reneayoroa/Instrumented-Insole/README.md

# Instrumented-Insole
KiCAD Design files for an instrumented insole
