reneayoroa/Instrumented-Insole/Design_Files/Smart_Insole_2025/Smart_insoles_2025_v1/Project_library/20pin_1.00mm_connector_horizontal/ZF1-20-02-TM-WT.stp

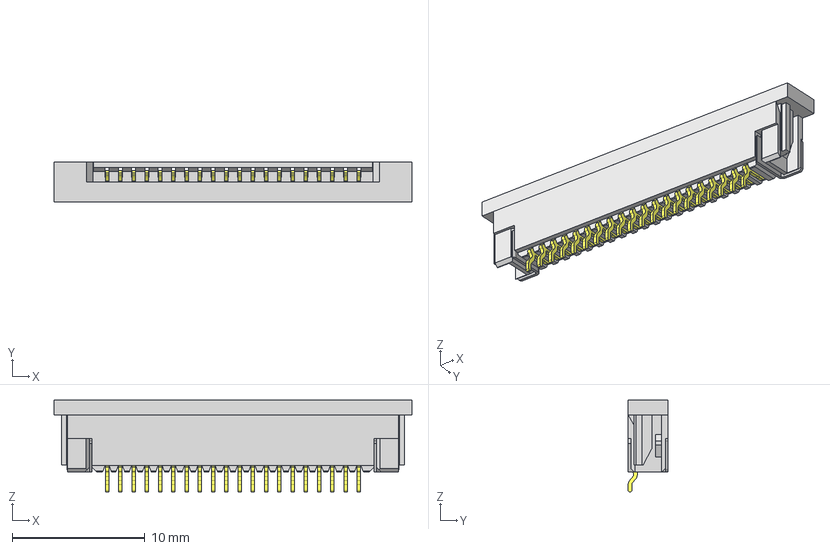
[picture p1: CAD file, 2025-10-01]
Design_Files/Smart_Insole_2025/Smart_insoles_2025_v1/Project_library/20pin_1.00mm_connector_horizontal/ZF1-20-02-TM-WT.stp
27.0 x 3.01 x 6.91 mm
ZF1-20-02-WT_housing
ZF1-20-02-WT_wt
ZF1-20-02-WT_contact
ZF1-02_CS2
ZF1-02_cs
