reneayoroa/Instrumented-Insole/Design_Files/Smart_Insole_2025/Smart_insoles_2025_v1/Project_library/3x3_TrimPot/TC33X-2-302E.step

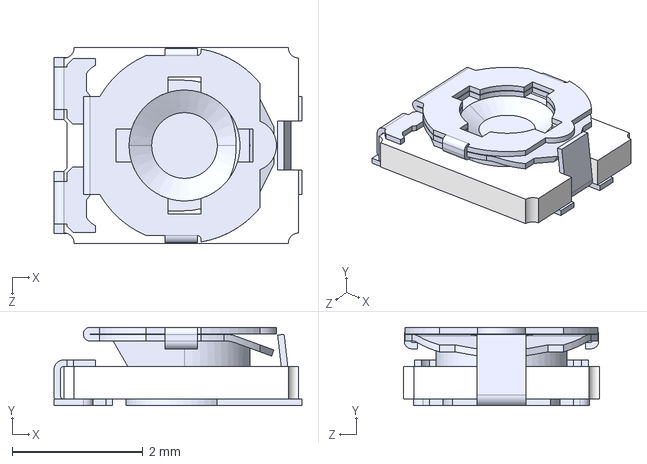
[picture p2: CAD file, 2025-08-20]
Design_Files/Smart_Insole_2025/Smart_insoles_2025_v1/Project_library/3x3_TrimPot/TC33X-2-302E.step
3.80 x 1.20 x 3.00 mm
