reneayoroa/Instrumented-Insole/Design_Files/Smart_Insole_2025/Smart_insoles_2025_v1/Project_library/ADM8829/ADM8829ARTZ-REEL.step

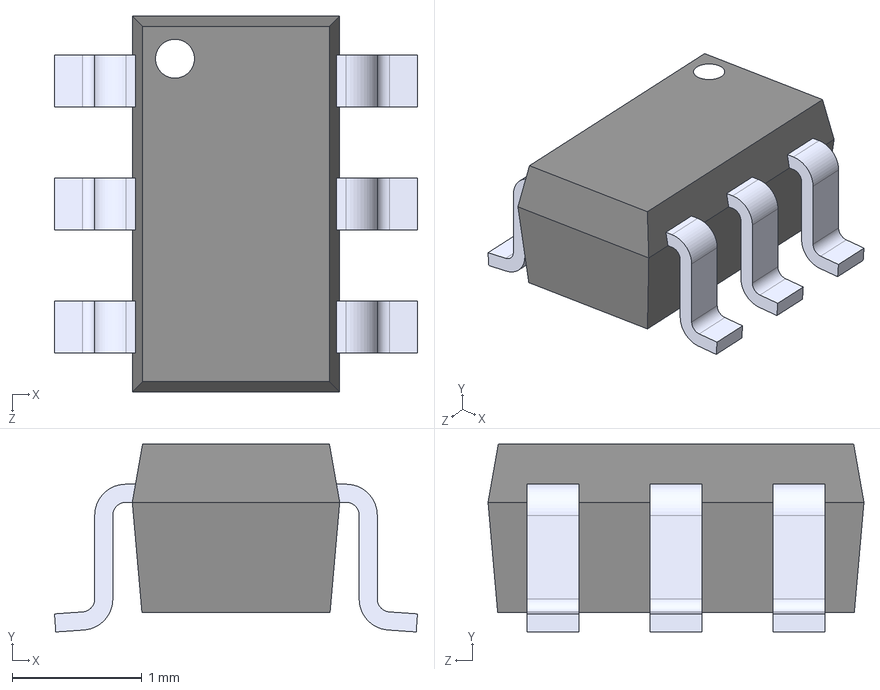
[picture p3: CAD file, 2025-07-16]
Design_Files/Smart_Insole_2025/Smart_insoles_2025_v1/Project_library/ADM8829/ADM8829ARTZ-REEL.step
2.80 x 1.45 x 2.90 mm
