reneayoroa/Instrumented-Insole/Design_Files/Smart_Insole_2025/Smart_insoles_2025_v1/Project_library/CD74HC4067M96--3DModel-STEP-56544.STEP

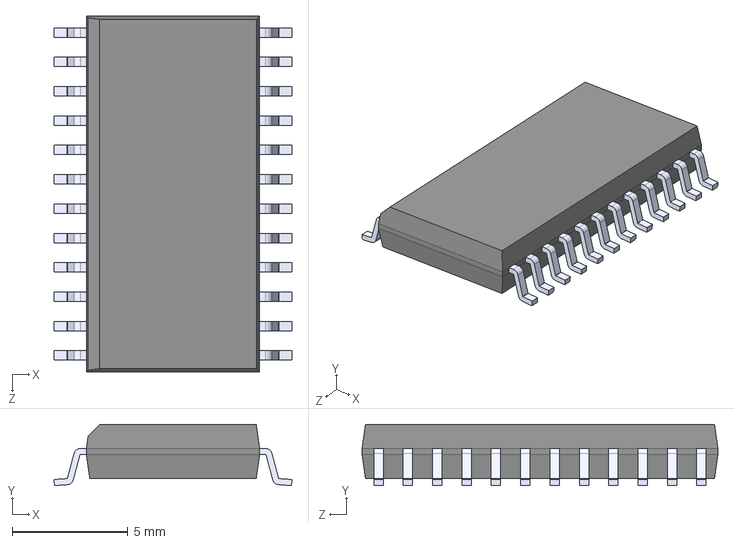
[picture p4: CAD file, 2025-06-03]
Design_Files/Smart_Insole_2025/Smart_insoles_2025_v1/Project_library/CD74HC4067M96--3DModel-STEP-56544.STEP
10.3 x 2.65 x 15.4 mm
