reneayoroa/Instrumented-Insole/Design_Files/Smart_Insole_2025/Smart_insoles_2025_v1/Project_library/ESP32-C3-MINI-1-N4/ESP32-C3-MINI-1-N4.step

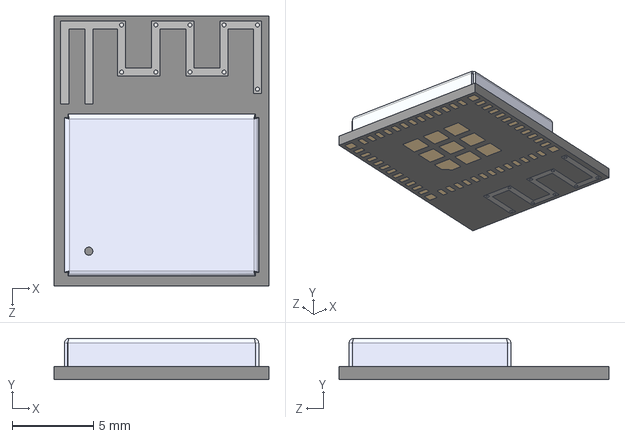
[picture p5: CAD file, 2025-09-10]
Design_Files/Smart_Insole_2025/Smart_insoles_2025_v1/Project_library/ESP32-C3-MINI-1-N4/ESP32-C3-MINI-1-N4.step
13.2 x 2.55 x 16.6 mm
