reneayoroa/Instrumented-Insole/Design_Files/Smart_Insole_2025/Smart_insoles_2025_v1/Project_library/ESP32-C3_SUPERMINI_SMD/ESP32-C3_SUPERMINI_SMD.step

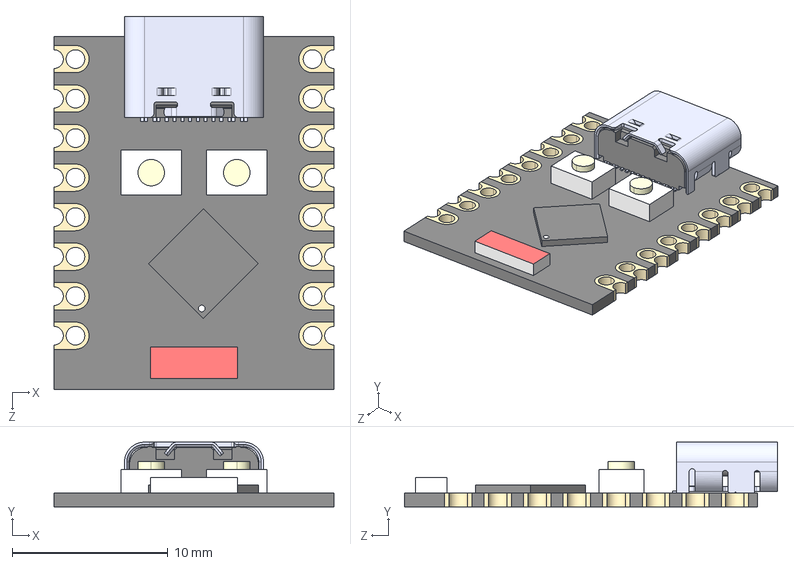
[picture p6: CAD file, 2025-06-03]
Design_Files/Smart_Insole_2025/Smart_insoles_2025_v1/Project_library/ESP32-C3_SUPERMINI_SMD/ESP32-C3_SUPERMINI_SMD.step
18.0 x 4.16 x 24.0 mm
Board c3mini
USB C
components (other)^ESP32-C3 SuperMini
