reneayoroa/Instrumented-Insole/Design_Files/Smart_Insole_2025/Smart_insoles_2025_v1/Project_library/FDN306P/FDN306P.step

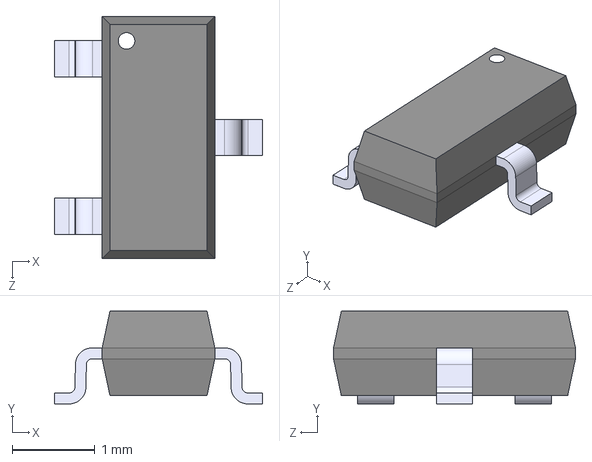
[picture p7: CAD file, 2025-09-24]
Design_Files/Smart_Insole_2025/Smart_insoles_2025_v1/Project_library/FDN306P/FDN306P.step
2.51 x 1.12 x 2.92 mm
