reneayoroa/Instrumented-Insole/Design_Files/Smart_Insole_2025/Smart_insoles_2025_v1/Project_library/GY-521/GY-521.step

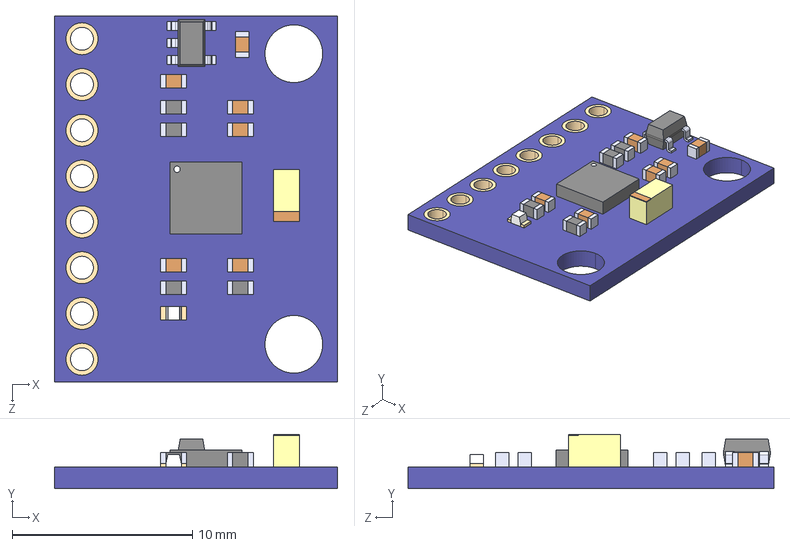
[picture p8: CAD file, 2025-06-03]
Design_Files/Smart_Insole_2025/Smart_insoles_2025_v1/Project_library/GY-521/GY-521.step
15.7 x 3.00 x 20.3 mm
