reneayoroa/Instrumented-Insole/Design_Files/Smart_Insole_2025/Smart_insoles_2025_v1/Project_library/JST-PH2-2.00MM-SMD-HORIZONTAL/S2B-PH-SM4-TB_LF__SN_.step

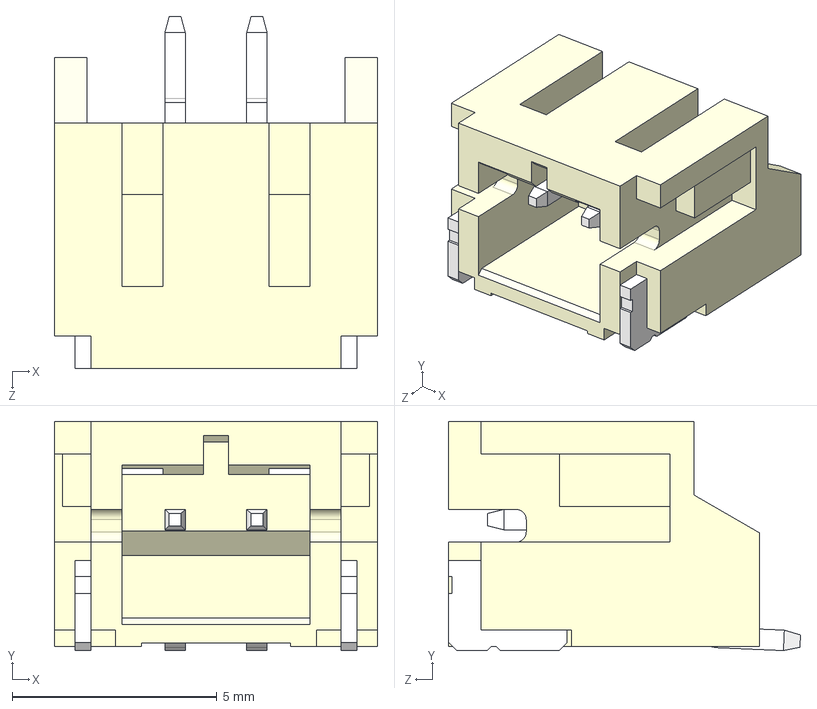
[picture p9: CAD file, 2025-08-27]
Design_Files/Smart_Insole_2025/Smart_insoles_2025_v1/Project_library/JST-PH2-2.00MM-SMD-HORIZONTAL/S2B-PH-SM4-TB_LF__SN_.step
7.90 x 5.60 x 8.60 mm
