reneayoroa/Instrumented-Insole/Design_Files/Smart_Insole_2025/Smart_insoles_2025_v1/Project_library/LDM6S032TR/LSM6DSO32TR.step

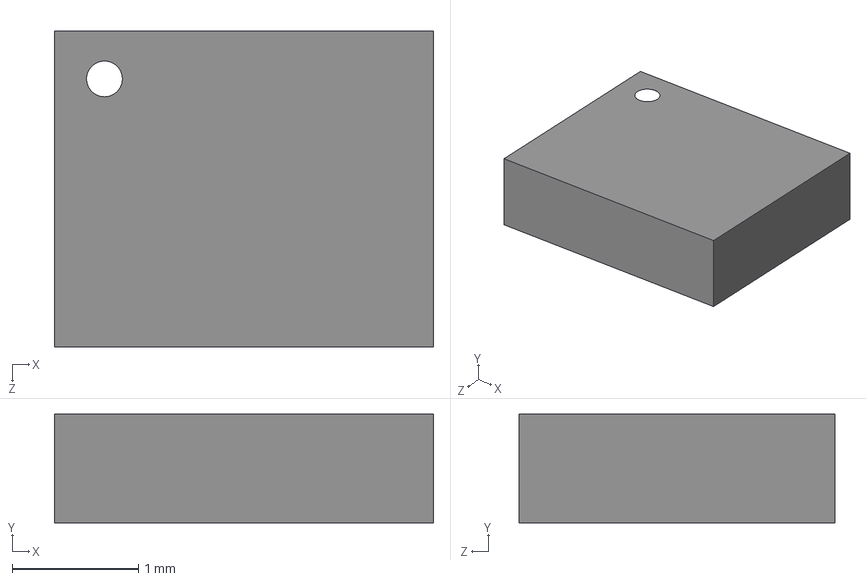
[picture p10: CAD file, 2025-08-26]
Design_Files/Smart_Insole_2025/Smart_insoles_2025_v1/Project_library/LDM6S032TR/LSM6DSO32TR.step
3.00 x 0.86 x 2.50 mm
