reneayoroa/Instrumented-Insole/Design_Files/Smart_Insole_2025/Smart_insoles_2025_v1/Project_library/MCP6004_I_ST/MCP6004-I_ST.step

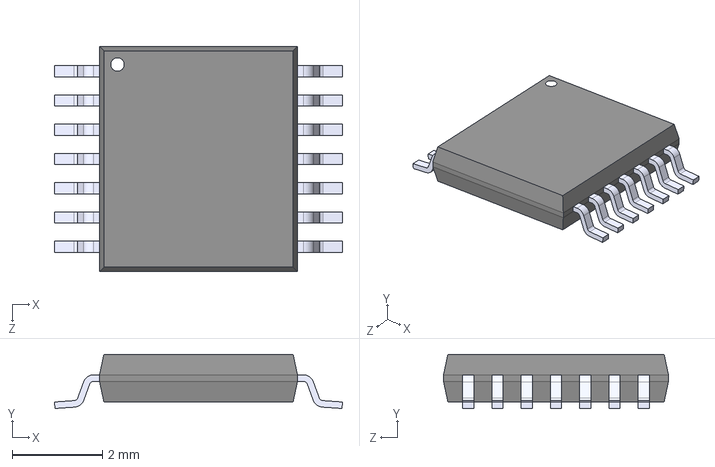
[picture p11: CAD file, 2025-08-19]
Design_Files/Smart_Insole_2025/Smart_insoles_2025_v1/Project_library/MCP6004_I_ST/MCP6004-I_ST.step
6.40 x 1.20 x 5.00 mm
