reneayoroa/Instrumented-Insole/Design_Files/Smart_Insole_2025/Smart_insoles_2025_v1/Project_library/USBLC6-2SC6/USBLC6-2SC6.stp

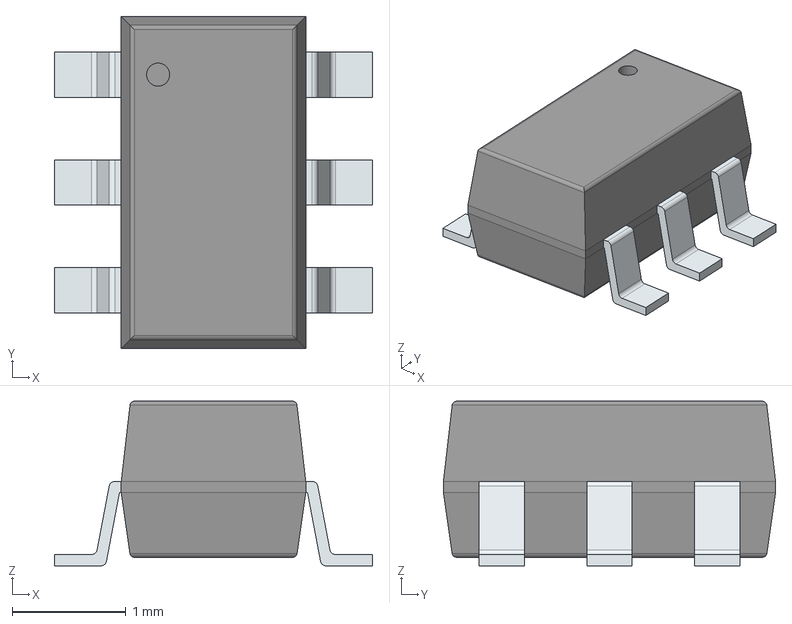
[picture p12: CAD file, 2025-10-01]
Design_Files/Smart_Insole_2025/Smart_insoles_2025_v1/Project_library/USBLC6-2SC6/USBLC6-2SC6.stp
2.80 x 2.92 x 1.45 mm
PinsArrayLR
