reneayoroa/Instrumented-Insole/Design_Files/Smart_Insole_2025/Smart_insoles_2025_v1/Project_library/BQ24040DSQR/BQ24040DSQR.step

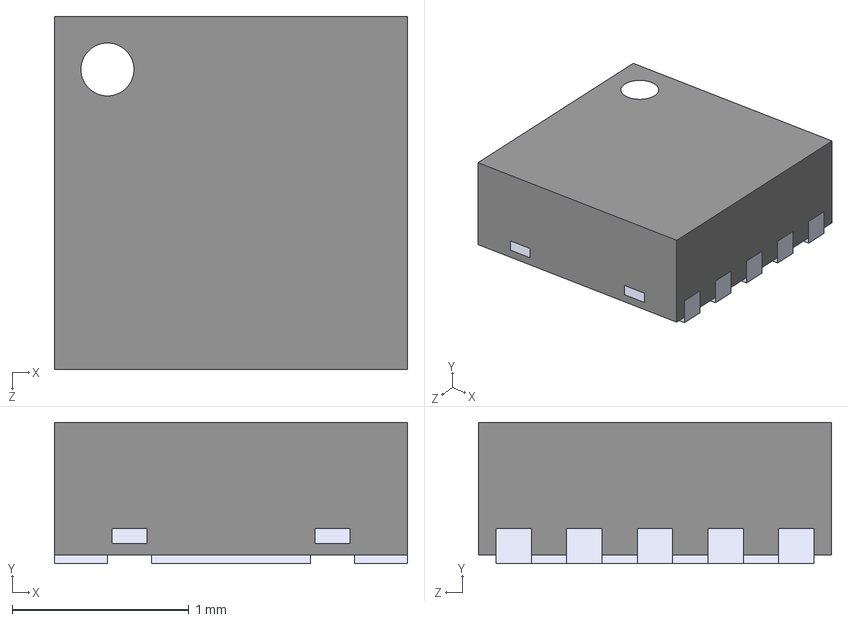
[picture p13: CAD file, 2025-09-25]
Design_Files/Smart_Insole_2025/Smart_insoles_2025_v1/Project_library/BQ24040DSQR/BQ24040DSQR.step
2.00 x 0.8 x 2.00 mm
