reneayoroa/Instrumented-Insole/Design_Files/Smart_Insole_2025/Smart_insoles_2025_v1/Output_files/Smart_insoles_2025_v1.pdf

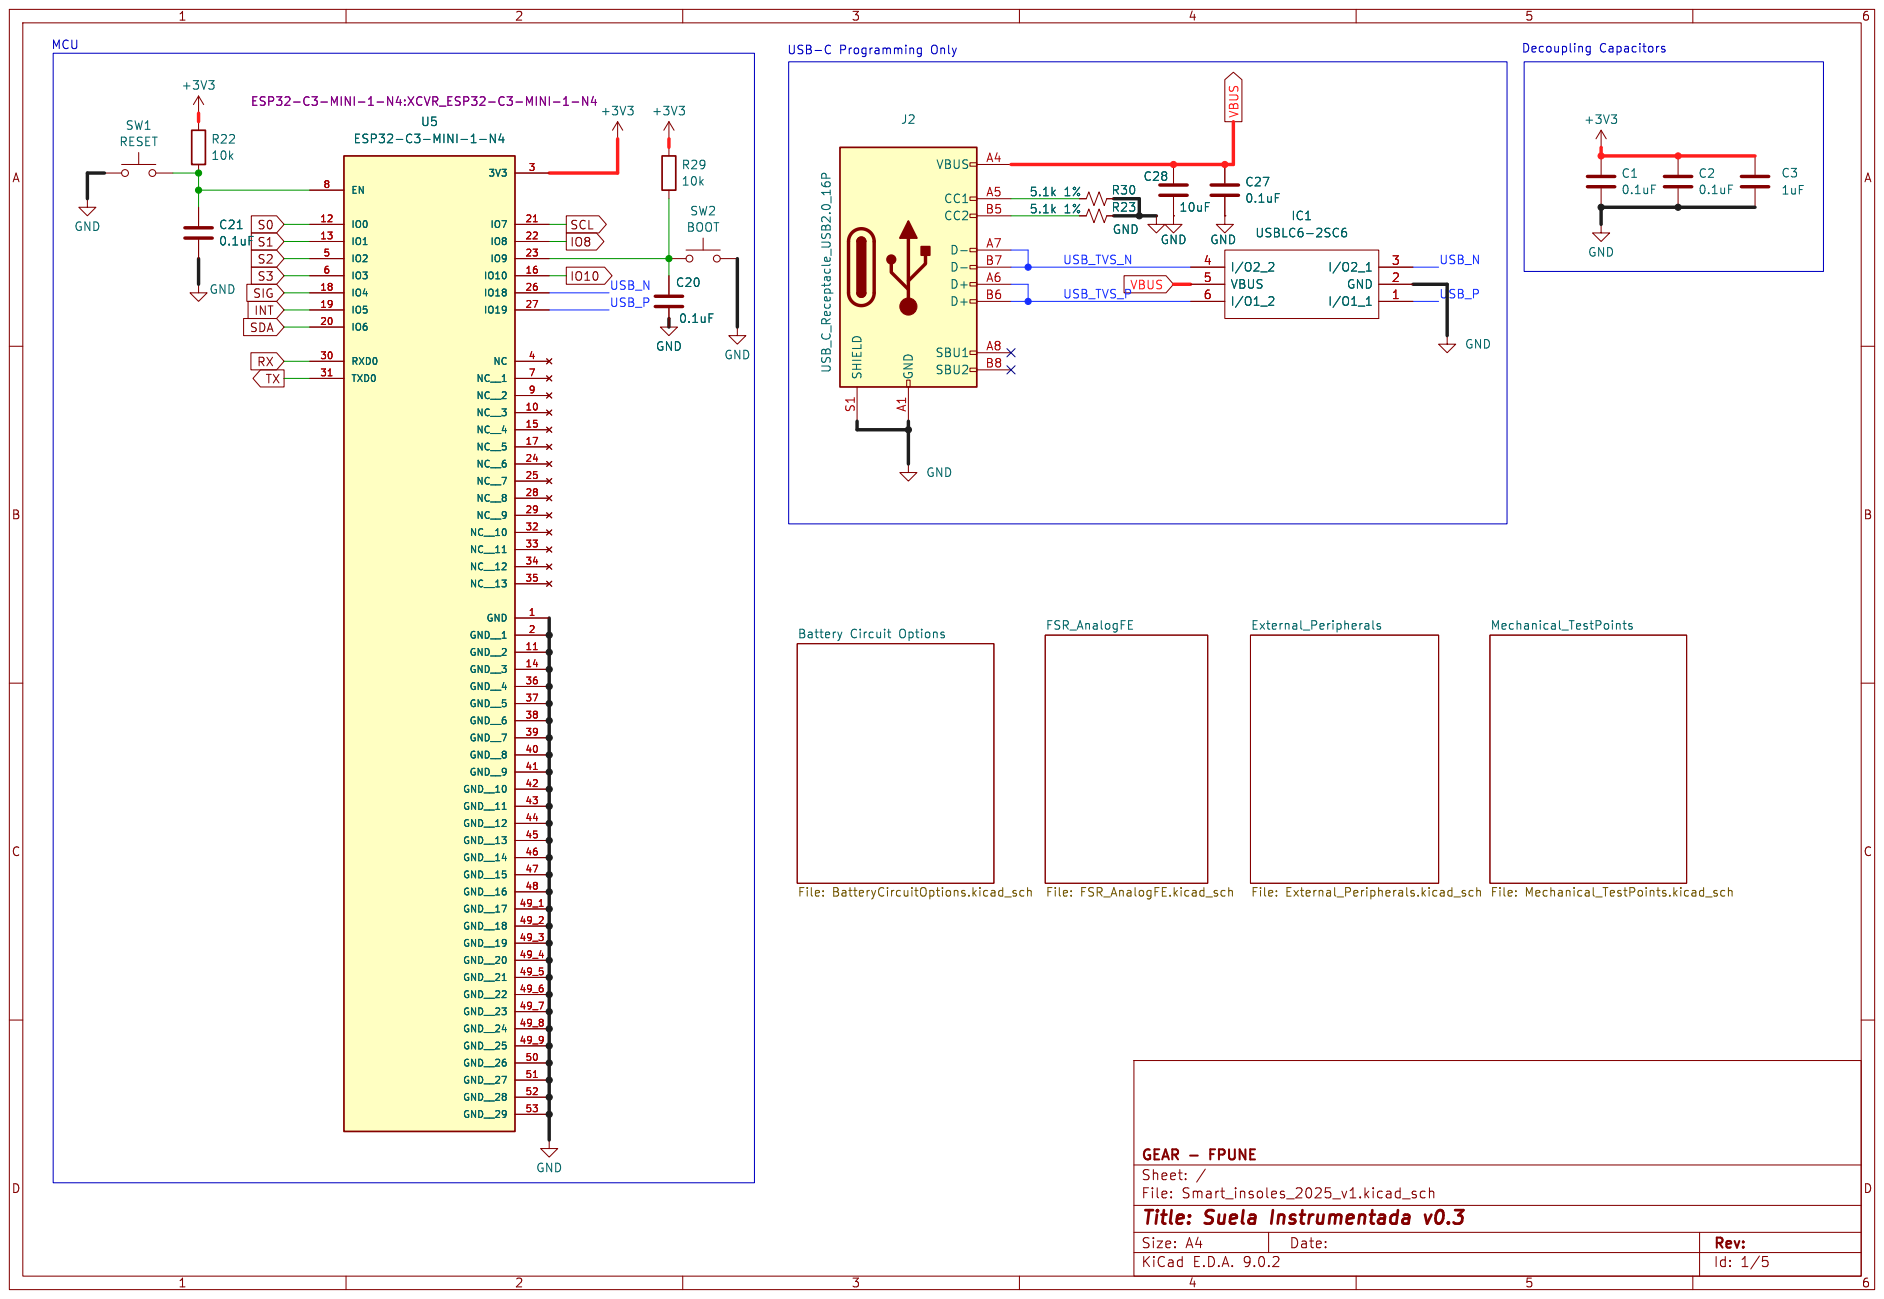
[picture p14: page 1]

Battery Circuit Options File: BatteryCircuitOptions.kicad_sch

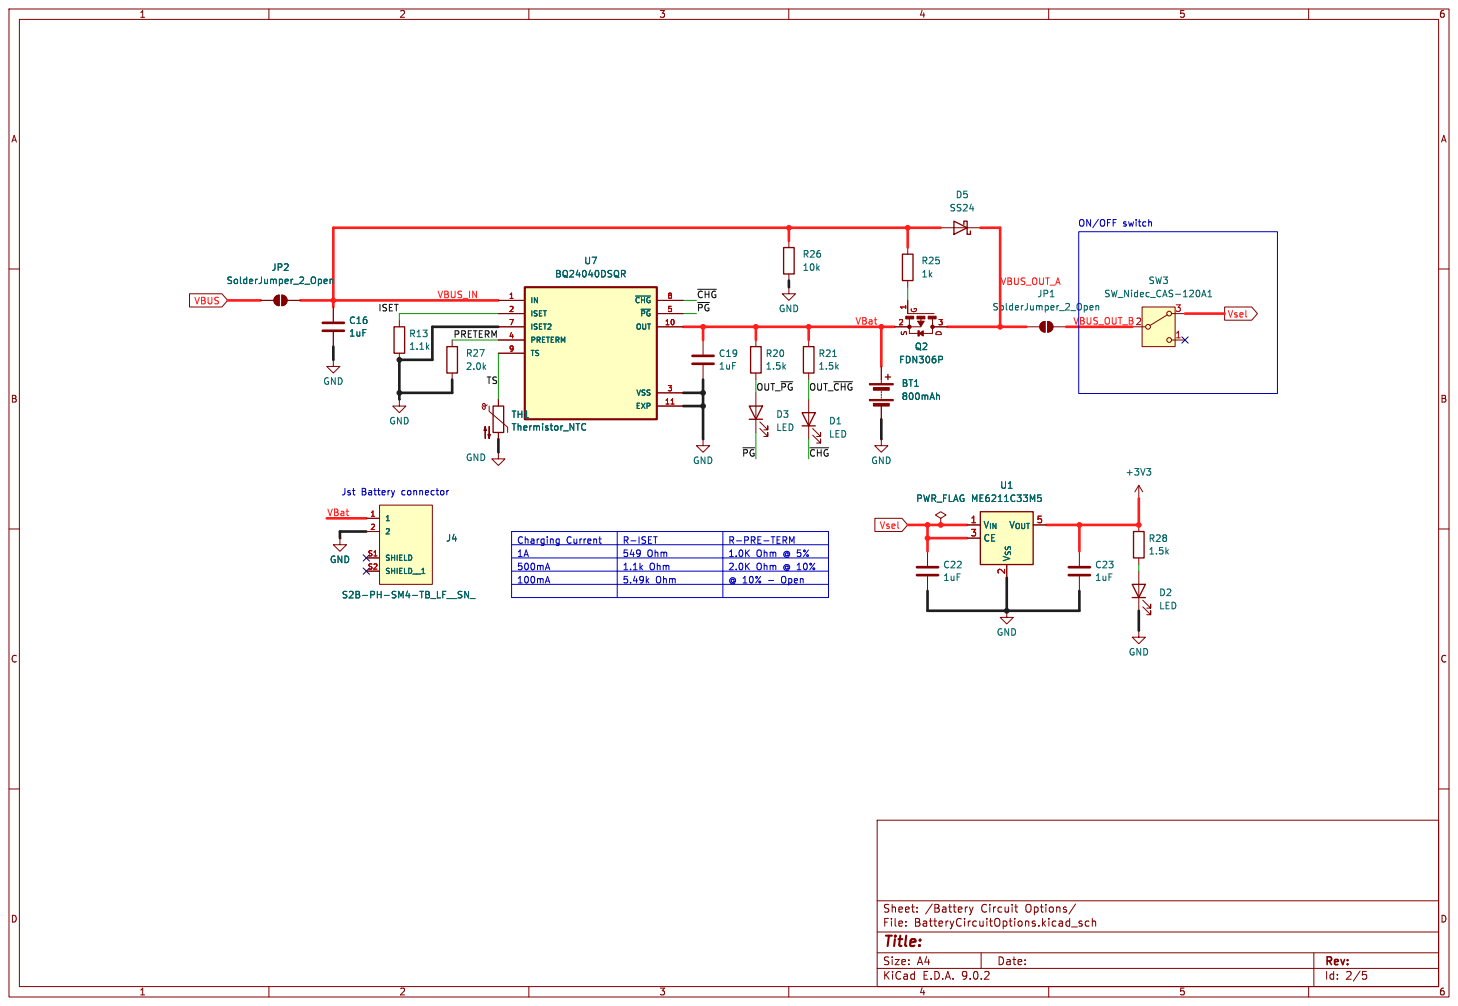
[picture p15: page 2]

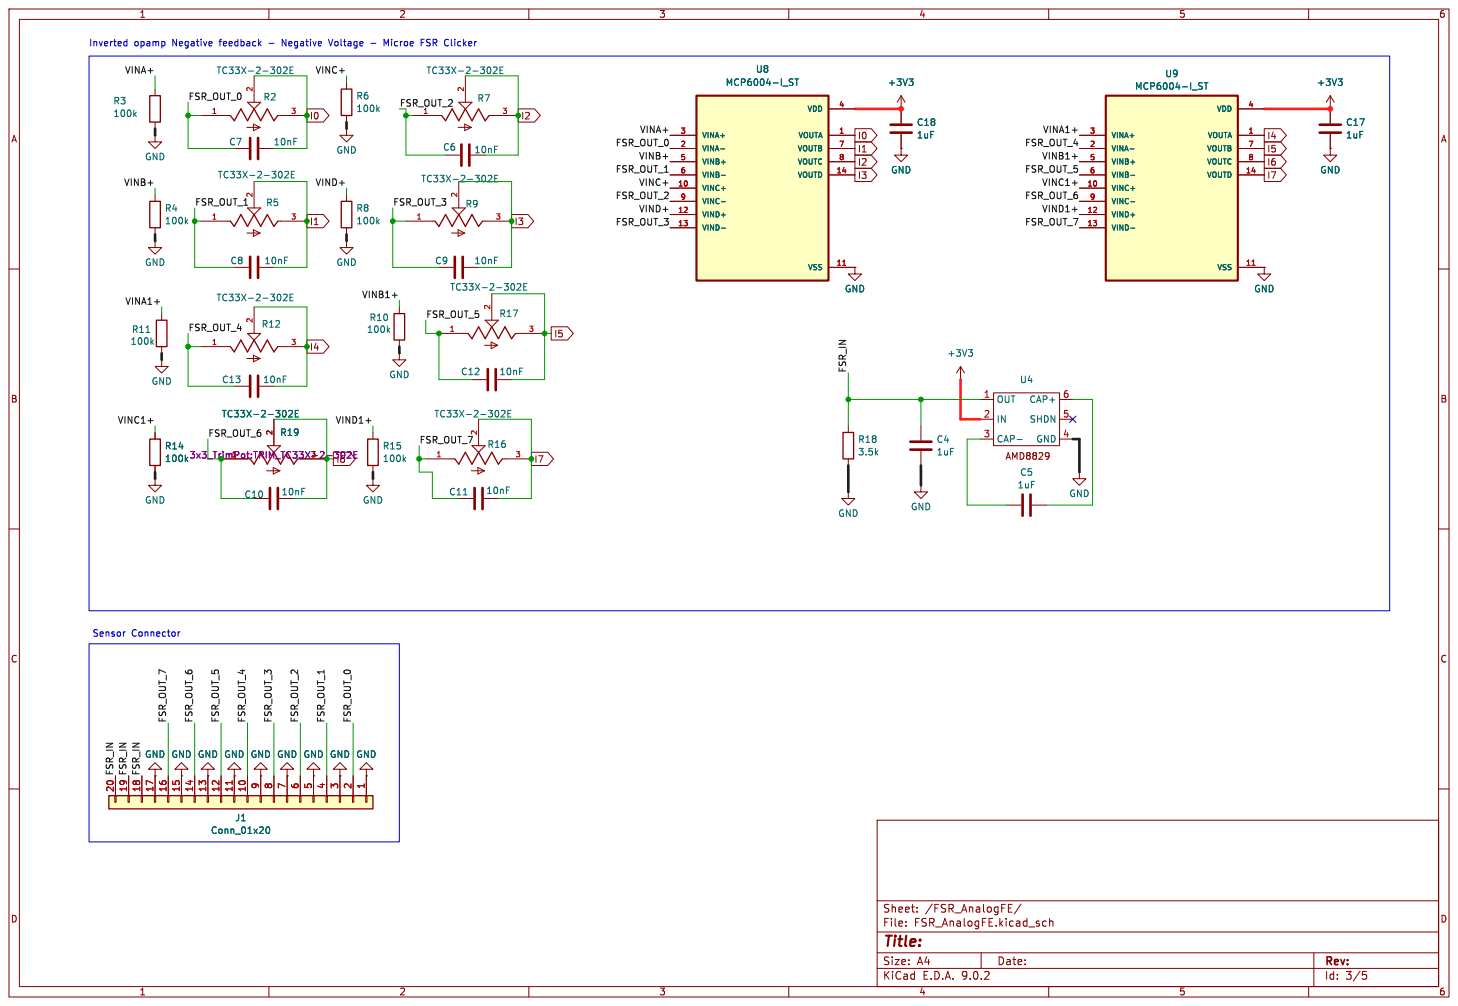
[picture p16: page 3]

Inverted opamp Negative feedback - Negative Voltage - Microe FSR Clicker Sensor Connector R14

12019181716151413121110 GND GND GND GND GND GND GND GND

Id: 3/5 Title: File: FSR_AnalogFE.kicad_sch Sheet: /FSR_AnalogFE/

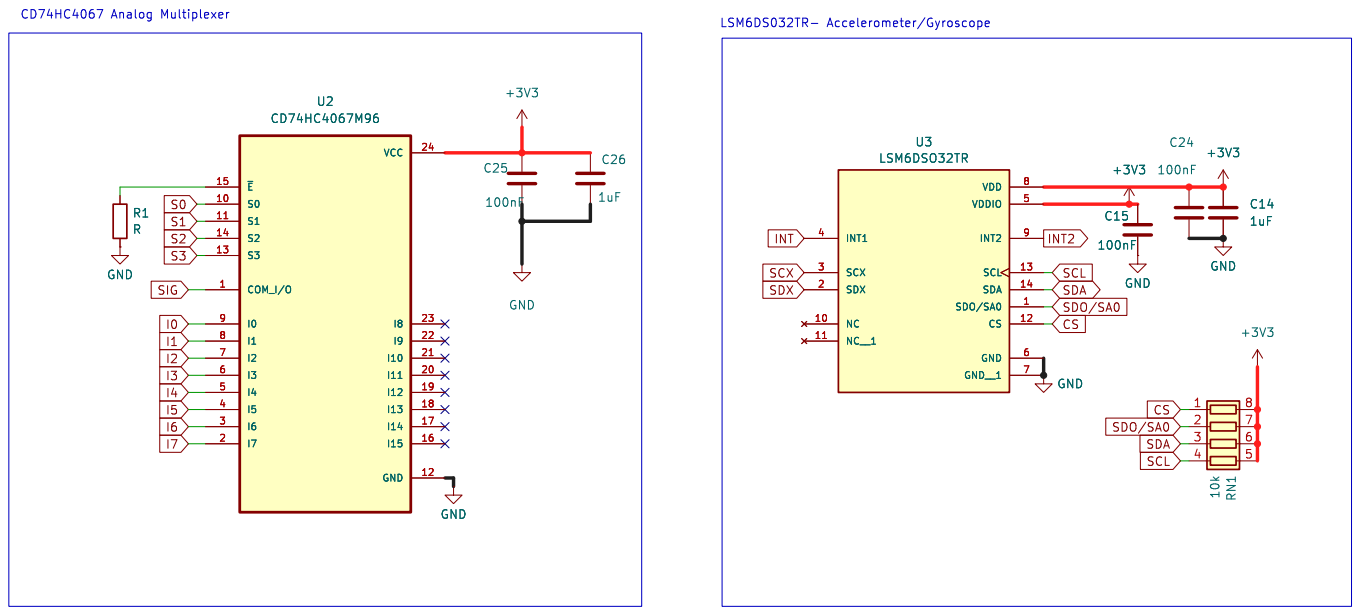
[picture p17: page 4]

Id: 4/5 Title: File: External_Peripherals.kicad_sch Sheet: /External_Peripherals/

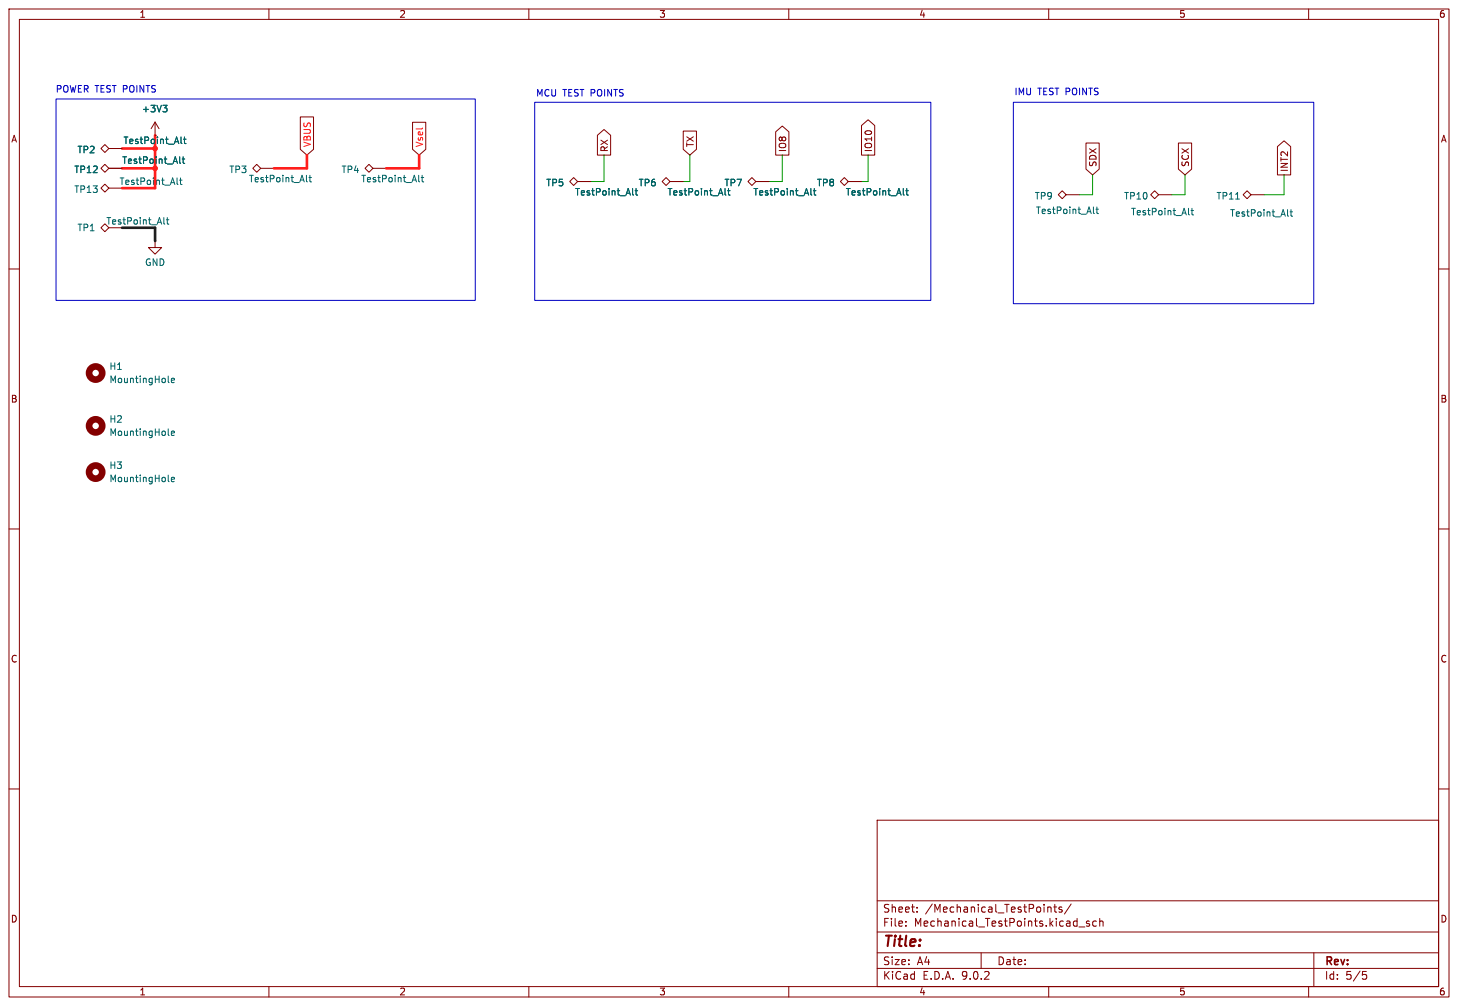
[picture p18: page 5]

Id: 5/5 Title: File: Mechanical_TestPoints.kicad_sch Sheet: /Mechanical_TestPoints/
