reneayoroa/Instrumented-Insole/Design_Files/Smart_Insole_2025/Smart_insoles_2025_v1/Smart_insoles_2025_v1.kicad_pcb

## KiCad design Design_Files/Smart_Insole_2025/Smart_insoles_2025_v1/Smart_insoles_2025_v1.kicad_pcb (2025-12-06)

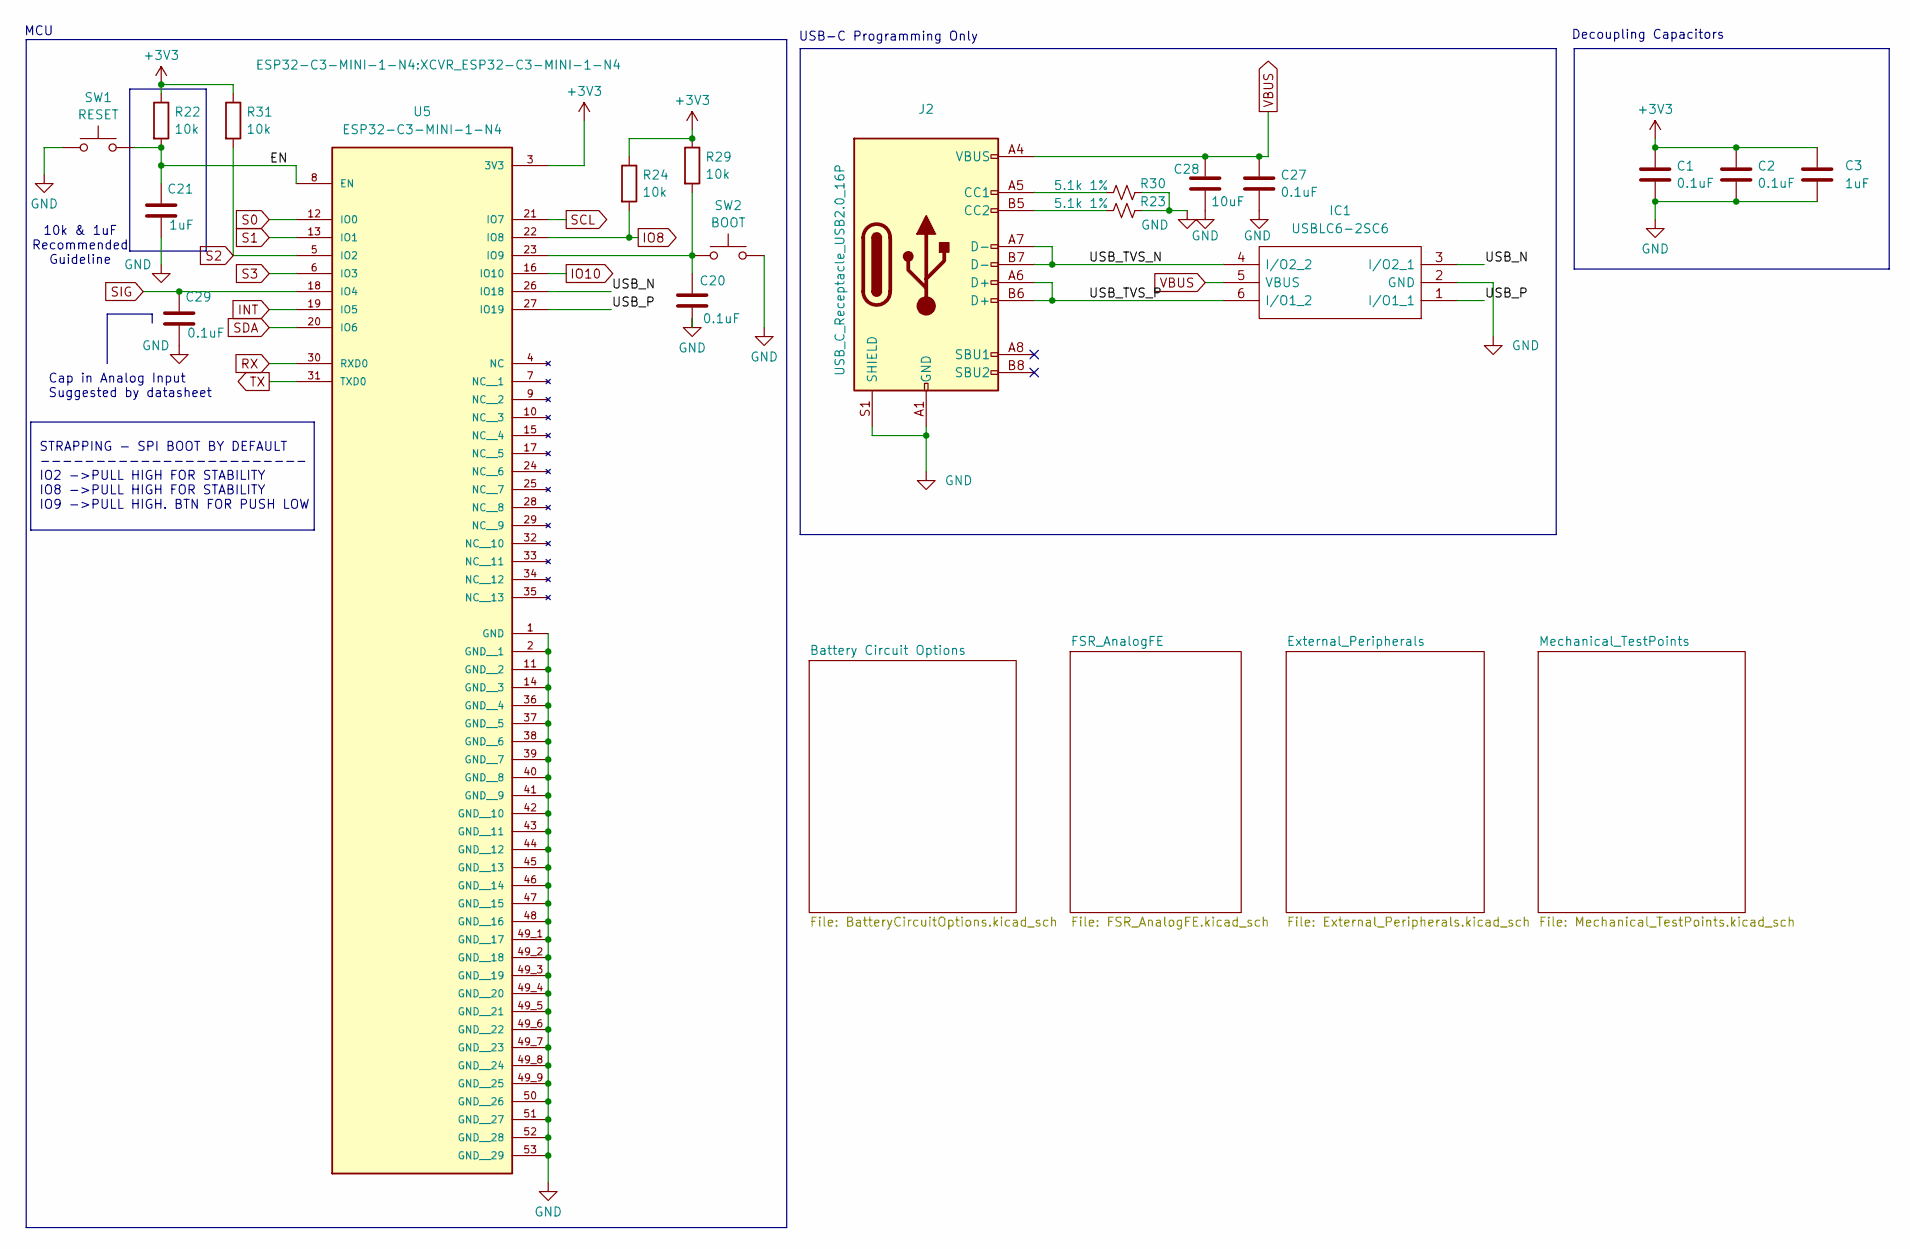
[picture p19: schematic Smart_insoles_2025_v1.kicad_sch, Suela Instrumentada v0.3]

Parts:
C1, C2, C20, C27, C29: 0.1uF; C_0805_2012Metric_Pad1.18x1.45mm_HandSolder
C3, C21: 1uF; C_0805_2012Metric_Pad1.18x1.45mm_HandSolder
C28: 10uF; C_0805_2012Metric_Pad1.18x1.45mm_HandSolder
IC1: USBLC6-2SC6; SOT95P280X145-6N; Mouser Part Number 511-USBLC6-2SC6
J2: USB_C_Receptacle_USB2.0_16P; USB_C_Receptacle_GCT_USB4105-xx-A_16P_TopMnt_Horizontal
R22, R24, R29, R31: 10k; R_0805_2012Metric
R23, R30: 5.1k 1%; R_0805_2012Metric
SW1: RESET; SW_Push_SPST_NO_Alps_SKRK
SW2: BOOT; SW_Push_SPST_NO_Alps_SKRK
U5: ESP32-C3-MINI-1-N4; XCVR_ESP32-C3-MINI-1-N4; PARTREV v1.0

Connections:
+3V3: C1.1, C2.1, C3.1, R22.1, R24.1, R29.1, R31.1, U5.3 (3V3); also elsewhere on the board
/EN: C21.2, R22.2, SW1.2, U5.8 (EN)
/USB_N: IC1.3 (I/O2_1), U5.26 (IO18)
/USB_P: IC1.1 (I/O1_1), U5.27 (IO19)
/USB_TVS_N: IC1.4 (I/O2_2), J2.A7 (D-), J2.B7 (D-)
/USB_TVS_P: IC1.6 (I/O1_2), J2.A6 (D+), J2.B6 (D+)
GND: C1.2, C2.2, C3.2, C20.1, C21.1, C27.2, C28.2, C29.1, IC1.2 (GND), J2.A1 (GND), J2.A12 (GND), J2.B1 (GND), J2.B12 (GND), J2.S1 (SHIELD), R23.2, R30.2, SW1.1, SW2.1, U5.1 (GND), U5.2 (GND__1), U5.11 (GND__2), U5.14 (GND__3), U5.36 (GND__4), U5.37 (GND__5), U5.38 (GND__6), U5.39 (GND__7), U5.40 (GND__8), U5.41 (GND__9), U5.42 (GND__10), U5.43 (GND__11), U5.44 (GND__12), U5.45 (GND__13), U5.46 (GND__14), U5.47 (GND__15), U5.48 (GND__16), U5.49_1 (GND__17), U5.49_2 (GND__18), U5.49_3 (GND__19), U5.49_4 (GND__20), U5.49_5 (GND__21), U5.49_6 (GND__22), U5.49_7 (GND__23), U5.49_8 (GND__24), U5.49_9 (GND__25), U5.50 (GND__26), U5.51 (GND__27), U5.52 (GND__28), U5.53 (GND__29); also elsewhere on the board
INT: U5.19 (IO5); also elsewhere on the board
IO8: R24.2, U5.22 (IO8); also elsewhere on the board
IO10: U5.16 (IO10); also elsewhere on the board
unnamed: J2.A5 (CC1), R30.1
unnamed: J2.B5 (CC2), R23.1
unnamed: C20.2, R29.2, SW2.2, U5.23 (IO9)
RX: U5.30 (RXD0); also elsewhere on the board
S0: U5.12 (IO0); also elsewhere on the board
S1: U5.13 (IO1); also elsewhere on the board
S2: R31.2, U5.5 (IO2); also elsewhere on the board
S3: U5.6 (IO3); also elsewhere on the board
SCL: U5.21 (IO7); also elsewhere on the board
SDA: U5.20 (IO6); also elsewhere on the board
SIG: C29.2, U5.18 (IO4); also elsewhere on the board
TX: U5.31 (TXD0); also elsewhere on the board
VBUS: C27.1, C28.1, IC1.5 (VBUS), J2.A4 (VBUS), J2.A9 (VBUS), J2.B4 (VBUS), J2.B9 (VBUS); also elsewhere on the board

Notes on the sheet:
USB-C Programming Only
STRAPPING - SPI BOOT BY DEFAULT ------------------------ IO2 ->PULL HIGH FOR STABILITY IO8 ->PULL HIGH FOR STABILITY IO9 ->PULL HIGH. BTN FOR PUSH LOW
MCU
10k & 1uF Recommended Guideline
Cap in Analog Input Suggested by datasheet
Decoupling Capacitors

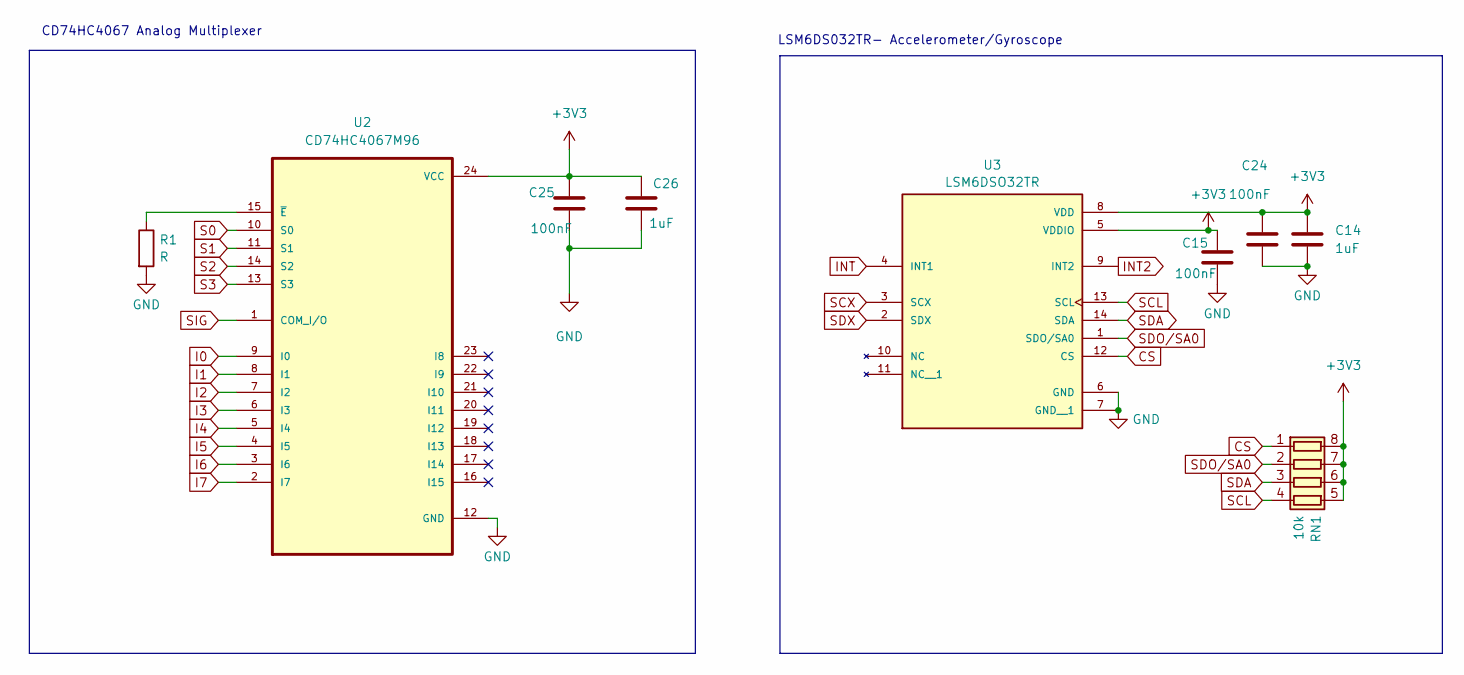
[picture p20: schematic External_Peripherals.kicad_sch]

Parts:
C14, C26: 1uF; C_0805_2012Metric_Pad1.18x1.45mm_HandSolder
C15, C24, C25: 100nF; C_0805_2012Metric_Pad1.18x1.45mm_HandSolder
R1: R; R_0805_2012Metric
RN1: 10k; R_Array_Concave_4x0603
U2: CD74HC4067M96; TSSOP-24_6.1x7.8mm_P0.65mm; DigiKey_Part_Number 296-29408-2-ND
U3: LSM6DSO32TR; XDCR_LSM6DSO32TR; PARTREV 1

Connections:
+3V3: C14.1, C15.1, C24.1, C25.1, C26.1, RN1.5 (R4.2), RN1.6 (R3.2), RN1.7 (R2.2), RN1.8 (R1.2), U2.24 (VCC), U3.5 (VDDIO), U3.8 (VDD); also elsewhere on the board
CS: RN1.1 (R1.1), U3.12 (CS)
GND: C14.2, C15.2, C24.2, C25.2, C26.2, R1.2, U2.12 (GND), U3.6 (GND), U3.7 (GND__1); also elsewhere on the board
I0: U2.9 (I0); also elsewhere on the board
I1: U2.8 (I1); also elsewhere on the board
I2: U2.7 (I2); also elsewhere on the board
I3: U2.6 (I3); also elsewhere on the board
I4: U2.5 (I4); also elsewhere on the board
I5: U2.4 (I5); also elsewhere on the board
I6: U2.3 (I6); also elsewhere on the board
I7: U2.2 (I7); also elsewhere on the board
INT: U3.4 (INT1); also elsewhere on the board
INT2: U3.9 (INT2); also elsewhere on the board
unnamed: R1.1, U2.15 (~E)
S0: U2.10 (S0); also elsewhere on the board
S1: U2.11 (S1); also elsewhere on the board
S2: U2.14 (S2); also elsewhere on the board
S3: U2.13 (S3); also elsewhere on the board
SCL: RN1.4 (R4.1), U3.13 (SCL); also elsewhere on the board
SCX: U3.3 (SCX); also elsewhere on the board
SDA: RN1.3 (R3.1), U3.14 (SDA); also elsewhere on the board
SDO/SA0: RN1.2 (R2.1), U3.1 (SDO/SA0); also elsewhere on the board
SDX: U3.2 (SDX); also elsewhere on the board
SIG: U2.1 (COM_I/O); also elsewhere on the board

Notes on the sheet:
LSM6DS032TR- Accelerometer/Gyroscope
CD74HC4067 Analog Multiplexer

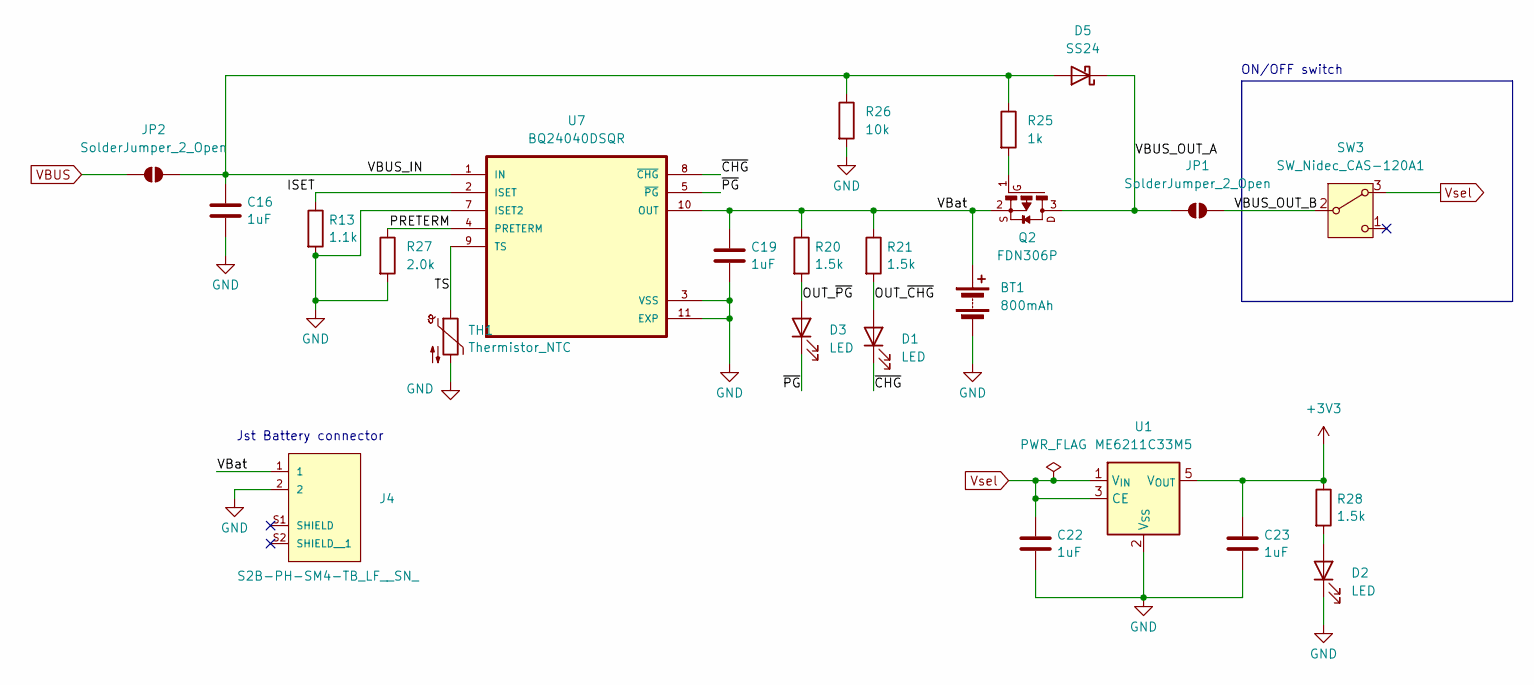
[picture p21: schematic BatteryCircuitOptions.kicad_sch]

Parts:
BT1: 800mAh
C16, C19, C22, C23: 1uF; C_0805_2012Metric_Pad1.18x1.45mm_HandSolder
D1, D2, D3: LED; LED_0805_2012Metric
D5: SS24; D_SMA
J4: S2B-PH-SM4-TB_LF__SN_; JST_S2B-PH-SM4-TB_LF__SN_
JP1, JP2: SolderJumper_2_Open; SolderJumper-2_P1.3mm_Open_RoundedPad1.0x1.5mm
Q2: FDN306P; SSOT-3
R13: 1.1k; R_0805_2012Metric_Pad1.20x1.40mm_HandSolder
R20, R21, R28: 1.5k; R_0805_2012Metric_Pad1.20x1.40mm_HandSolder
R25: 1k; R_0805_2012Metric_Pad1.20x1.40mm_HandSolder
R26: 10k; R_0805_2012Metric_Pad1.20x1.40mm_HandSolder
R27: 2.0k; R_0805_2012Metric_Pad1.20x1.40mm_HandSolder
SW3: SW_Nidec_CAS-120A1; SW_Slide-03_Wuerth-WS-SLTV_10x2.5x6.4_P2.54mm
TH1: Thermistor_NTC; thermistor_10k_NTC_SolderPad
U1: ME6211C33M5; SOT-23-5
U7: BQ24040DSQR; SON40P200X200X80-11N

Connections:
+3V3: C23.2, R28.1, U1.5 (V_{OUT}); also elsewhere on the board
/Battery Circuit Options/ISET: R13.1, U7.2 (ISET)
/Battery Circuit Options/OUT_~CHG: D1.2 (A), R21.2
/Battery Circuit Options/OUT_~PG: D3.2 (A), R20.2
/Battery Circuit Options/PRETERM: R27.1, U7.4 (PRETERM)
/Battery Circuit Options/TS: TH1.1, U7.9 (TS)
/Battery Circuit Options/VBUS_IN: C16.2, D5.2 (A), JP2.2 (B), R25.1, R26.1, U7.1 (IN)
/Battery Circuit Options/VBUS_OUT_A: D5.1 (K), JP1.1 (A), Q2.3
/Battery Circuit Options/VBUS_OUT_B: JP1.2 (B), SW3.2 (B)
/Battery Circuit Options/VBat: BT1.1 (+), C19.2, J4.1, Q2.2, R20.1, R21.1, U7.10 (OUT)
/Battery Circuit Options/~CHG: D1.1 (K), U7.8 (~CHG)
/Battery Circuit Options/~PG: D3.1 (K), U7.5 (~PG)
GND: BT1.2 (-), C16.1, C19.1, C22.1, C23.1, D2.1 (K), J4.2, R13.2, R26.2, R27.2, TH1.2, U1.2 (V_{SS}), U7.3 (VSS), U7.7 (ISET2), U7.11 (EXP); also elsewhere on the board
unnamed: D2.2 (A), R28.2
unnamed: Q2.1, R25.2
VBUS: JP2.1 (A); also elsewhere on the board
Vsel: C22.2, SW3.3 (A), U1.1 (V_{IN}), U1.3 (CE); also elsewhere on the board

Notes on the sheet:
ON/OFF switch
Jst Battery connector

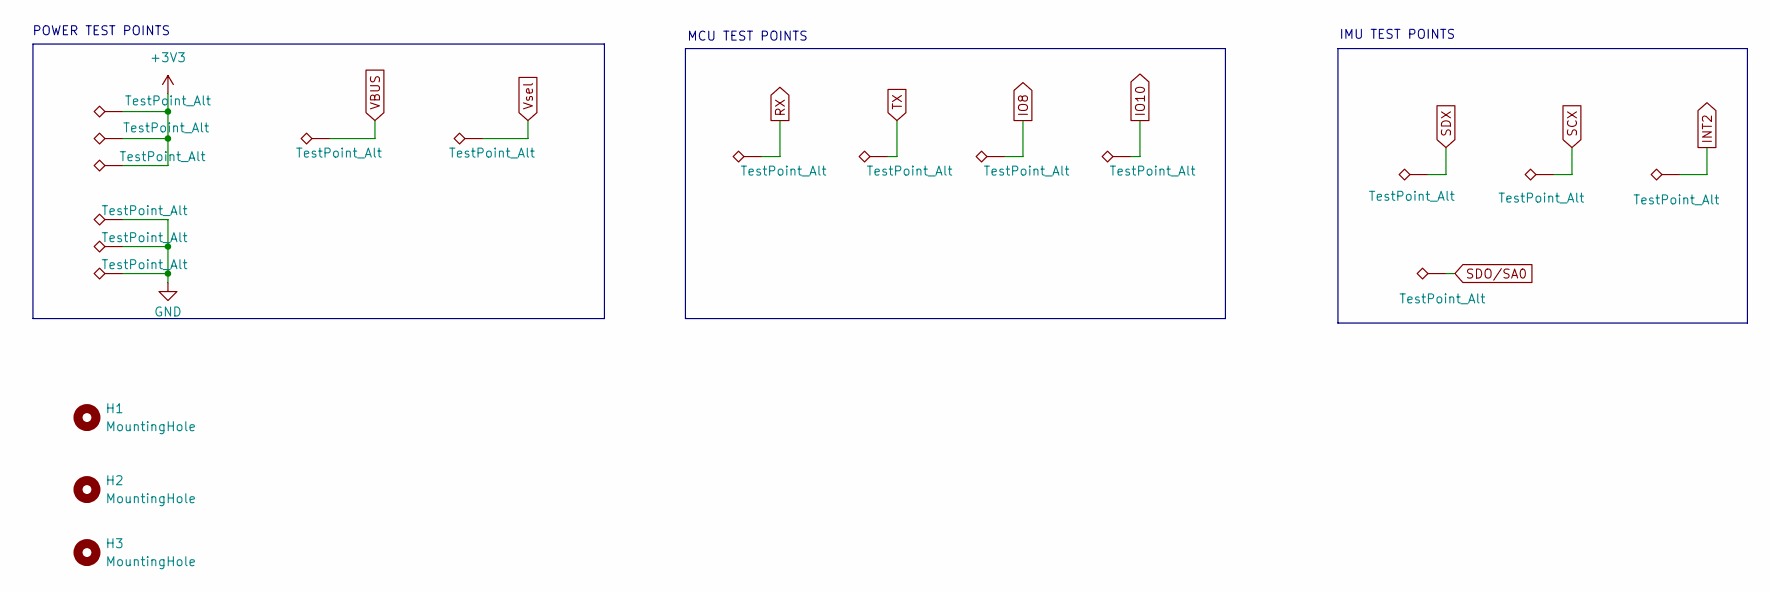
[picture p22: schematic Mechanical_TestPoints.kicad_sch]

Parts:
H1, H2, H3: MountingHole; MountingHole_2.1mm
TP1, TP2, TP3, TP4, TP5, TP6, TP7, TP8, TP9, TP10, TP11, TP12, TP13, TP14, TP15, TP16: TestPoint_Alt; TestPoint_Pad_D1.0mm

Connections:
+3V3: TP2.1, TP12.1, TP13.1; also elsewhere on the board
GND: TP1.1, TP15.1, TP16.1; also elsewhere on the board
INT2: TP11.1; also elsewhere on the board
IO8: TP7.1; also elsewhere on the board
IO10: TP8.1; also elsewhere on the board
RX: TP5.1; also elsewhere on the board
SCX: TP10.1; also elsewhere on the board
SDO/SA0: TP14.1; also elsewhere on the board
SDX: TP9.1; also elsewhere on the board
TX: TP6.1; also elsewhere on the board
VBUS: TP3.1; also elsewhere on the board
Vsel: TP4.1; also elsewhere on the board

Notes on the sheet:
POWER TEST POINTS
IMU TEST POINTS
MCU TEST POINTS

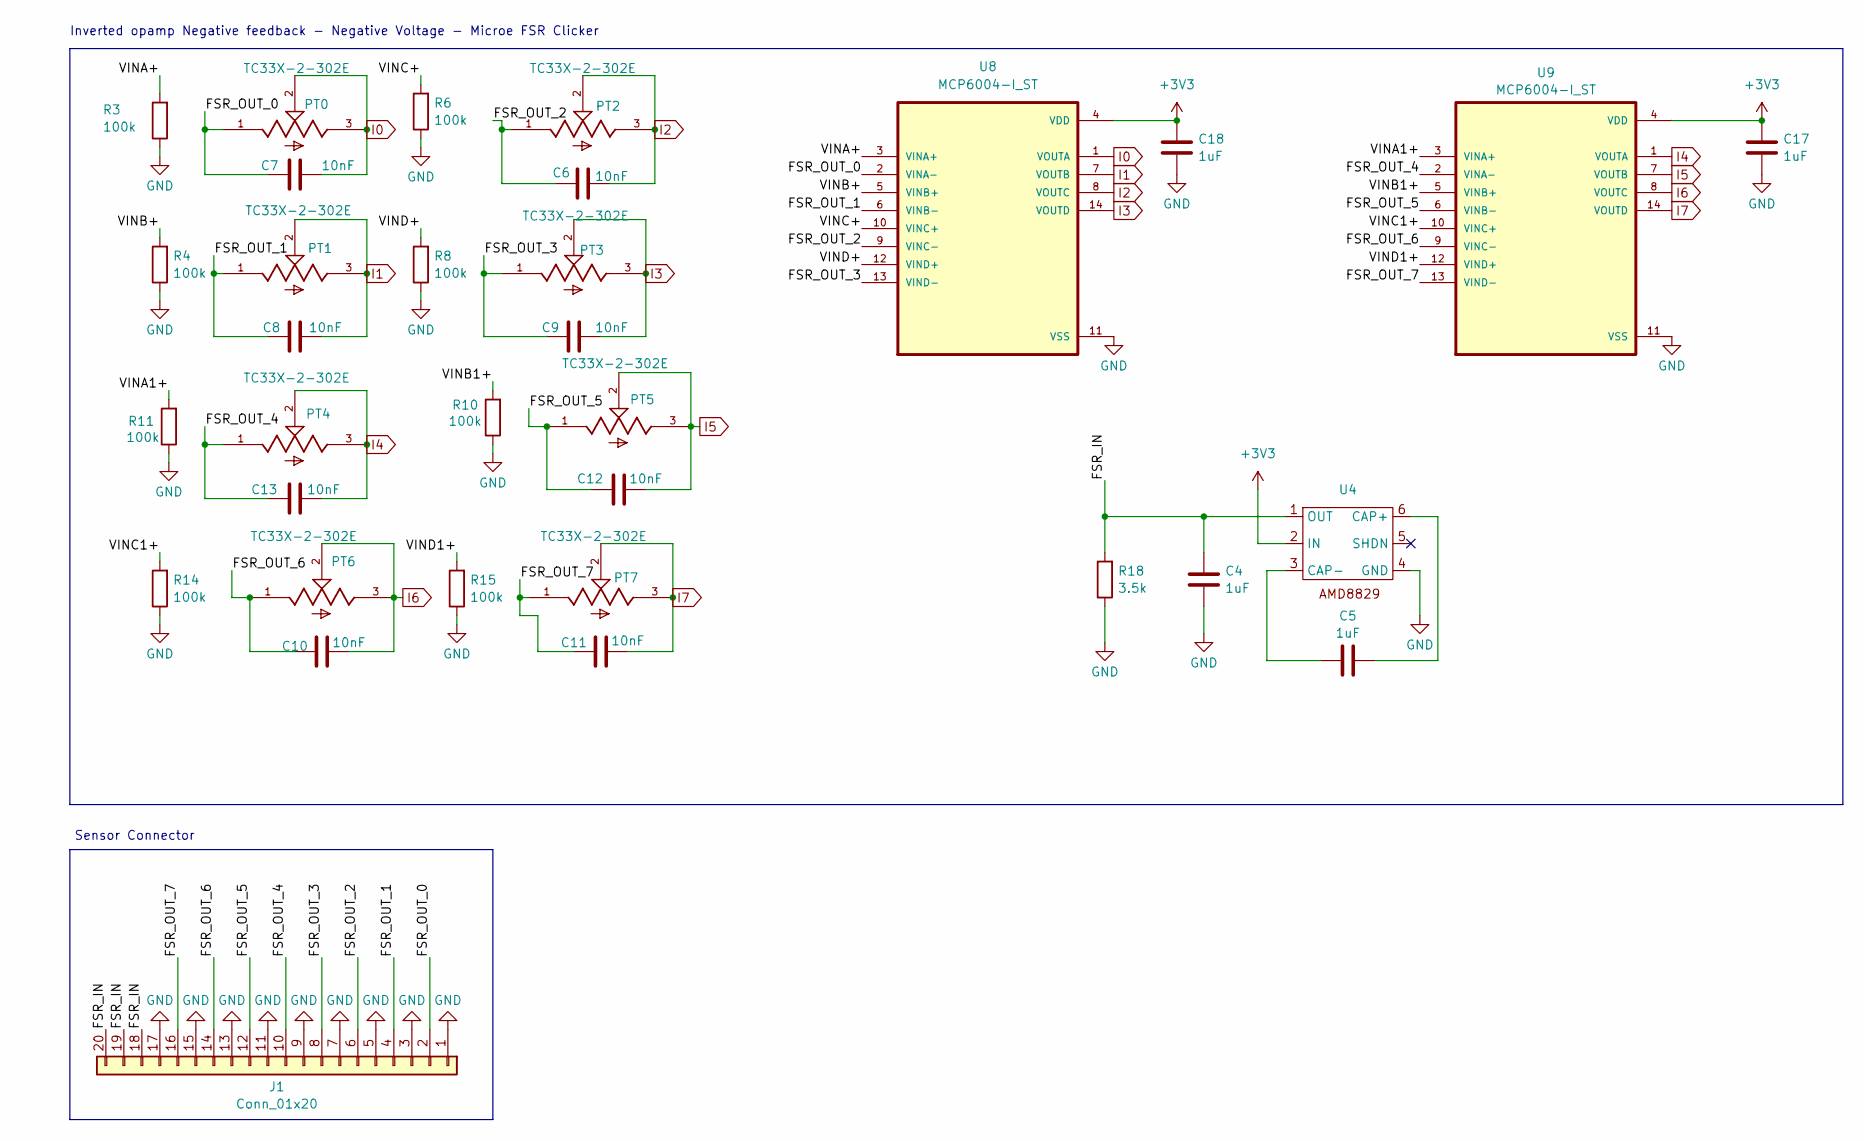
[picture p23: schematic FSR_AnalogFE.kicad_sch]

Parts:
C4, C5, C17, C18: 1uF; C_0805_2012Metric_Pad1.18x1.45mm_HandSolder
C6, C7, C8, C9, C10, C11, C12, C13: 10nF; C_0805_2012Metric_Pad1.18x1.45mm_HandSolder
J1: Conn_01x20; Samtec_T1M-20-X-S-RA_1x20-1MP_P1.0mm_Terminal_Horizontal
PT0, PT1, PT2, PT3, PT4, PT5, PT6, PT7: TC33X-2-302E; TRIM_TC33X-2-302E
R3, R4, R6, R10, R11, R14, R15: 100k; R_0805_2012Metric
R8: 100k; R_0805_2012Metric_Pad1.20x1.40mm_HandSolder
R18: 3.5k; R_0805_2012Metric
U4: SOT95P280X145-6N
U8, U9: MCP6004-I_ST; custom

Connections:
+3V3: C17.1, C18.1, U4.2 (IN), U8.4 (VDD), U9.4 (VDD); also elsewhere on the board
/FSR_AnalogFE/FSR_IN: C4.1, J1.18, J1.19, J1.20, R18.2, U4.1 (OUT)
/FSR_AnalogFE/FSR_OUT_0: C7.1, J1.2, PT0.1, U8.2 (VINA-)
/FSR_AnalogFE/FSR_OUT_1: C8.1, J1.4, PT1.1, U8.6 (VINB-)
/FSR_AnalogFE/FSR_OUT_2: C6.1, J1.6, PT2.1, U8.9 (VINC-)
/FSR_AnalogFE/FSR_OUT_3: C9.1, J1.8, PT3.1, U8.13 (VIND-)
/FSR_AnalogFE/FSR_OUT_4: C13.1, J1.10, PT4.1, U9.2 (VINA-)
/FSR_AnalogFE/FSR_OUT_5: C12.1, J1.12, PT5.1, U9.6 (VINB-)
/FSR_AnalogFE/FSR_OUT_6: C10.1, J1.14, PT6.1, U9.9 (VINC-)
/FSR_AnalogFE/FSR_OUT_7: C11.1, J1.16, PT7.1, U9.13 (VIND-)
/FSR_AnalogFE/VINA1+: R11.2, U9.3 (VINA+)
/FSR_AnalogFE/VINA+: R3.2, U8.3 (VINA+)
/FSR_AnalogFE/VINB1+: R10.2, U9.5 (VINB+)
/FSR_AnalogFE/VINB+: R4.2, U8.5 (VINB+)
/FSR_AnalogFE/VINC1+: R14.2, U9.10 (VINC+)
/FSR_AnalogFE/VINC+: R6.2, U8.10 (VINC+)
/FSR_AnalogFE/VIND1+: R15.2, U9.12 (VIND+)
/FSR_AnalogFE/VIND+: R8.2, U8.12 (VIND+)
GND: C4.2, C17.2, C18.2, J1.1, J1.3, J1.5, J1.7, J1.9, J1.11, J1.13, J1.15, J1.17, R3.1, R4.1, R6.1, R8.1, R10.1, R11.1, R14.1, R15.1, R18.1, U4.4 (GND), U8.11 (VSS), U9.11 (VSS); also elsewhere on the board
I0: C7.2, PT0.2, PT0.3, U8.1 (VOUTA); also elsewhere on the board
I1: C8.2, PT1.2, PT1.3, U8.7 (VOUTB); also elsewhere on the board
I2: C6.2, PT2.2, PT2.3, U8.8 (VOUTC); also elsewhere on the board
I3: C9.2, PT3.2, PT3.3, U8.14 (VOUTD); also elsewhere on the board
I4: C13.2, PT4.2, PT4.3, U9.1 (VOUTA); also elsewhere on the board
I5: C12.2, PT5.2, PT5.3, U9.7 (VOUTB); also elsewhere on the board
I6: C10.2, PT6.2, PT6.3, U9.8 (VOUTC); also elsewhere on the board
I7: C11.2, PT7.2, PT7.3, U9.14 (VOUTD); also elsewhere on the board
unnamed: C5.2, U4.6 (CAP+)
unnamed: C5.1, U4.3 (CAP-)

Notes on the sheet:
Inverted opamp Negative feedback - Negative Voltage - Microe FSR Clicker
Sensor Connector

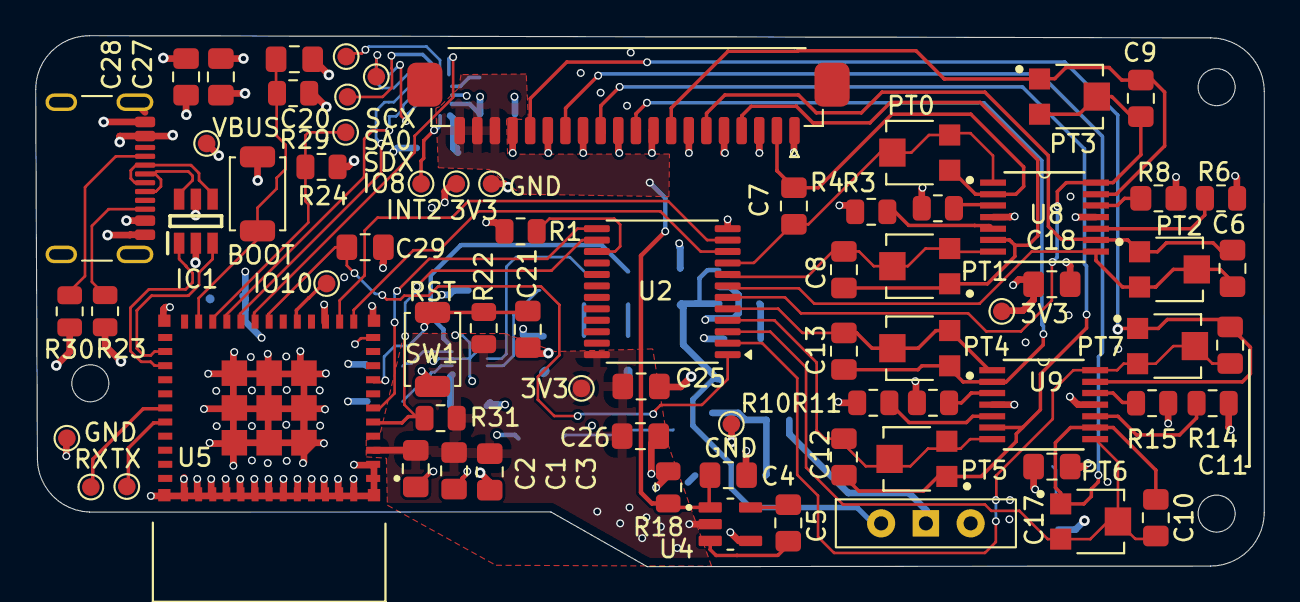
[picture p24: board Smart_insoles_2025_v1.kicad_pcb from above]

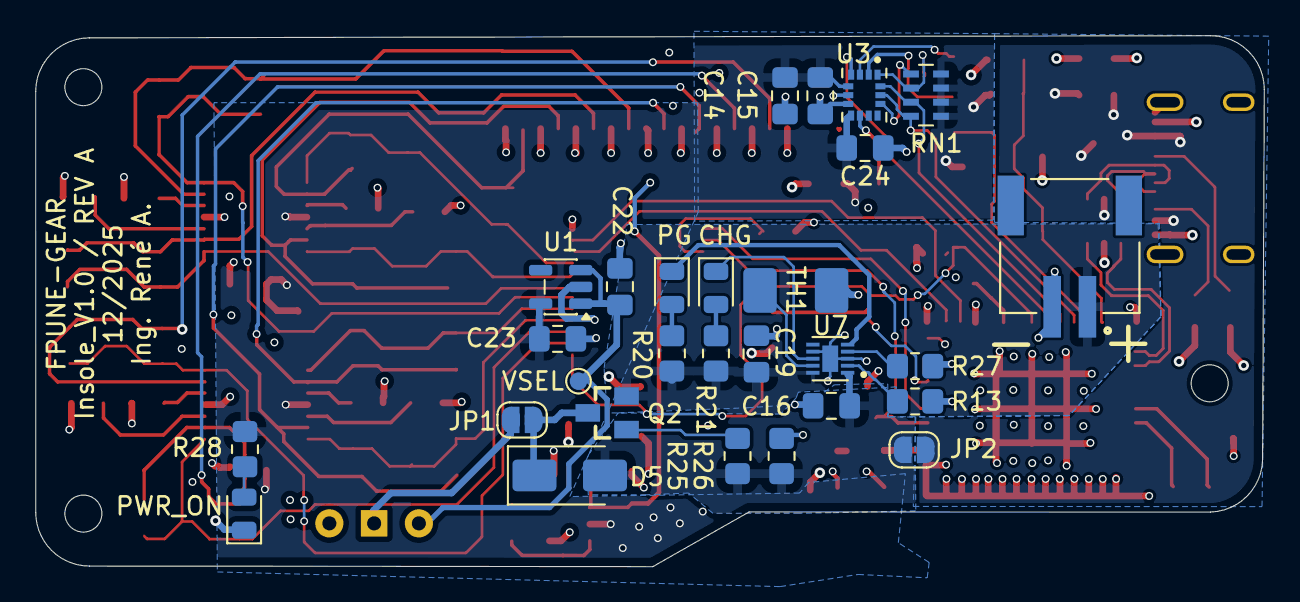
[picture p25: board Smart_insoles_2025_v1.kicad_pcb from below]

Board: 4 copper layers, 69.7 x 30.1 mm, 103 parts (28 on the bottom side), 70 nets.
