reneayoroa/Instrumented-Insole/(commit log)

2025-06-20 updated Schematic & PCB layout
    [Smart_insoles_2025_v1.kicad_pcb, Smart_insoles_2025_v1.kicad_sch]
2025-06-21 Changing MCU orientation + Rerouting
    [Smart_insoles_2025_v1.kicad_pcb]
2025-07-01 modified project outline and routing.
    [Smart_insoles_2025_v1.kicad_pcb]
2025-07-16 Added AFE from mikroe clicker schematic. Reorganized Schematic in general
    [ADM8829ARTZ-REEL.step, BatteryCircuitOptions.kicad_sch, FSR_AnalogFE.kicad_sch, Smart_insoles_2025_v1.kicad_pcb, Smart_insoles_2025_v1.kicad_sch]
2025-07-19 Added different AFE circuits to the schematic. Needs verification
    [BatteryCircuitOptions.kicad_sch, FSR_AnalogFE.kicad_sch, Smart_insoles_2025_v1.kicad_sch]
2025-07-23 Added capacitor to negative feedback fsr circuit
    [FSR_AnalogFE.kicad_sch]
2025-08-19 Project division to account for multiple AFE conditioning circuit
    [ADM8829ARTZ-REEL.step, AFE_p1.kicad_pcb, AFE_p1.kicad_sch, BatteryCircuitOptions.kicad_sch, CD74HC4067M96--3DModel-STEP-56544.STEP, CD74HC4067M96.step, ESP32-C3 SuperMini--3DModel-STEP-56544.STEP, ESP32-C3_SUPERMINI_SMD.step]
2025-08-20 added 3x3 trimpot symbol/footprint. Also Modify schematic to add 3x3trimpots
    [FSR_AnalogFE.kicad_sch, Smart_insoles_2025_v1.kicad_sch, TC33X-2-302E.step]
2025-08-21 Added capacitors to the AFE
    [FSR_AnalogFE.kicad_sch]
2025-08-26 Change accelerometer to Lsm6ds033
    [FSR_AnalogFE.kicad_sch, LSM6DSO32TR.step, Smart_insoles_2025_v1.kicad_pcb, Smart_insoles_2025_v1.kicad_sch]
2025-08-27 Added battery connector footprint. Grouping componnets in PcbNew
    [BatteryCircuitOptions.kicad_sch, FSR_AnalogFE.kicad_sch, S2B-PH-SM4-TB_LF__SN_.step, Smart_insoles_2025_v1.kicad_pcb, Smart_insoles_2025_v1.kicad_sch]
2025-09-04 PCBNew. AFE component grouping
    [Smart_insoles_2025_v1.kicad_pcb]
2025-09-05 PCBnew:Moving placed components. Fixed REF of mcp component
    [BatteryCircuitOptions.kicad_sch, FSR_AnalogFE.kicad_sch, Smart_insoles_2025_v1.kicad_pcb, Smart_insoles_2025_v1.kicad_sch, fsr.kicad_pcb, fsr.kicad_sch]
2025-09-10 PCB new moving things around
    [BatteryCircuitOptions.kicad_sch, ESP32-C3-MINI-1-N4.step, FSR_AnalogFE.kicad_sch, Smart_insoles_2025_v1.kicad_pcb, Smart_insoles_2025_v1.kicad_sch]
2025-09-19 Changed Mcu to esp32c3 mini 1 n4
    [BatteryCircuitOptions.kicad_sch, Smart_insoles_2025_v1.kicad_sch]
2025-09-23 SCH: Advances in Battery circuit. Added External_Periph sheet
    [BatteryCircuitOptions.kicad_sch, External_Peripherals.kicad_sch, FSR_AnalogFE.kicad_sch, Smart_insoles_2025_v1.kicad_sch]
2025-09-24 SCH: Added TVS diode on USB. Defined transistor and diode for battery/usb charging/switching
    [BatteryCircuitOptions.kicad_sch, FDN306P.step, Smart_insoles_2025_v1.kicad_sch]
2025-09-24 SCH:Solved Errors in ERC
    [BatteryCircuitOptions.kicad_sch, External_Peripherals.kicad_sch, Smart_insoles_2025_v1.kicad_sch]
2025-09-25 SCH: Added missing footprints. PCB: Grouped related components for new layout
    [BQ24040DSQR.step, BatteryCircuitOptions.kicad_sch, External_Peripherals.kicad_sch, FSR_AnalogFE.kicad_sch, Smart_insoles_2025_v1.kicad_pcb, Smart_insoles_2025_v1.kicad_sch]
2025-09-27 SCH: Fixed Warnings. Added thermistor solder pads library.
    [BatteryCircuitOptions.kicad_sch, External_Peripherals.kicad_sch, FSR_AnalogFE.kicad_sch, Smart_insoles_2025_v1.kicad_pcb, Smart_insoles_2025_v1.kicad_sch]
2025-09-27 SCH: Added Power Test points and Mounting Holes. PCB: Arranged grouped Footprints to minimize rounting
    [BatteryCircuitOptions.kicad_sch, Mechanical_TestPoints.kicad_sch, Smart_insoles_2025_v1.kicad_pcb, Smart_insoles_2025_v1.kicad_sch]
2025-09-27 SCH: Added FSR_In missing connections.
    [FSR_AnalogFE.kicad_sch, Smart_insoles_2025_v1.kicad_pcb]
2025-09-28 PCB:Initial positioning of grouped footprints
    [Smart_insoles_2025_v1.kicad_pcb, Smart_insoles_2025_v1.kicad_sch]
2025-09-30 SCH: Added test points on idle MCU pins and Power supply. Added ON/OFF switch on VSEL.
    [BatteryCircuitOptions.kicad_sch, External_Peripherals.kicad_sch, FSR_AnalogFE.kicad_sch, Mechanical_TestPoints.kicad_sch, Smart_insoles_2025_v1.kicad_sch]
2025-10-01 PCB: Added 3d models to all components. Also preliminar routing of componentes. Component placemente needs checking.
    [BatteryCircuitOptions.kicad_sch, FSR_AnalogFE.kicad_sch, Mechanical_TestPoints.kicad_sch, Smart_insoles_2025_v1.kicad_pcb, Smart_insoles_2025_v1.kicad_sch, USBLC6-2SC6.stp, ZF1-20-02-TM-WT.stp]
2025-10-15 PCB:Routing missing connection. Still some missing
    [BatteryCircuitOptions.kicad_sch, Smart_insoles_2025_v1.kicad_pcb, Smart_insoles_2025_v1.kicad_sch]
2025-11-12 PCB:new routing-p1
    [Smart_insoles_2025_v1.kicad_pcb]
2025-11-13 PCB: finished routing single ended signal. Pending usb differential pair
    [Smart_insoles_2025_v1.kicad_pcb]
2025-11-27 SCH:Added pullup resistors on strapping pins.Added 0.1uF on analog input. Added testpoint on missing pad. PCB:Placed new components.Routing refactoring p1
    [BatteryCircuitOptions.kicad_sch, Mechanical_TestPoints.kicad_sch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]
2025-12-01 PCB: Routing refactoring. Moved Multiplexer to the right. Organized Silkscreen p1. USB DIFF NOT READY
    [BatteryCircuitOptions.kicad_sch, Smart_insoles_2025_v1.kicad_pcb]
2025-12-03 PCB: Added power puddles on Vbat,3v3, VBUS
    [Mechanical_TestPoints.kicad_sch, Smart_insoles_2025_v1.kicad_pcb]
2025-12-04 PCB:USB Differential pair Impedance calculation and Routing. Also Organized Silkscreen. Added text polarity to battery, boot and rst buttons, and RX TX
    [External_Peripherals.kicad_sch, FSR_AnalogFE.kicad_sch, Smart_insoles_2025_v1.kicad_pcb, Smart_insoles_2025_v1.kicad_sch]
2025-12-04 PCB:Fixed Multiplexer wrong footprint. Flex Connector modified. Fixed DRC Errors and Warnings
    [External_Peripherals.kicad_sch, Mechanical_TestPoints.kicad_sch, Smart_insoles_2025_v1.kicad_pcb, Smart_insoles_2025_v1.kicad_sch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]
2025-12-04 Modified some footprints to better fit real components.
    [External_Peripherals.kicad_sch, Smart_insoles_2025_v1.kicad_pcb]
2025-12-06 PCB: Changed USB position. VERSION SENT TO JLCPCB
    [Mechanical_TestPoints.kicad_sch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]
