reneayoroa/Instrumented-Insole/(notices)

Notices in the files:
Design_Files/Smart_Insole_2025/Smart_insoles_2025_v1/Project_library/20pin_1.00mm_connector_horizontal/ZF1-20-02-TM-WT.stp:
author */ ('License CC BY-ND 4.0'),
